Open-Lab-Starter-Kit/OLSK-Large-Laser/OLSK_Large_Laser_V1/README.md

<div align="center"><h1 style=align="center">OLSK Large Laser V1</h1></div>


<div align="center"><i>Open Source Laser Cutter - Large version - Open Lab Starter Kit</i></div>

<br>

Introduction
--

The OLSK Large Laser V1 is a powerful 75W CO2 laser cutter with large cutting area of 1000 x 700 mm. It can move at a high speed and precision of 0.05mm. With an innovative slim design (1520 x 1120 x 400 mm W x D x H), it is build with a full aluminum and an isolated cutting chamber, separated from the mechanics, electronics and laser optics. It includes a coaxial laser pointer and homing with inductive sensors. As an open source machine, it can be replicable in most Fab Labs and also industrially. The building have been simplified, compared to its predecessor Fabulaser Mini V2, with reduced number of parts and easier assembly process and laser calibration.

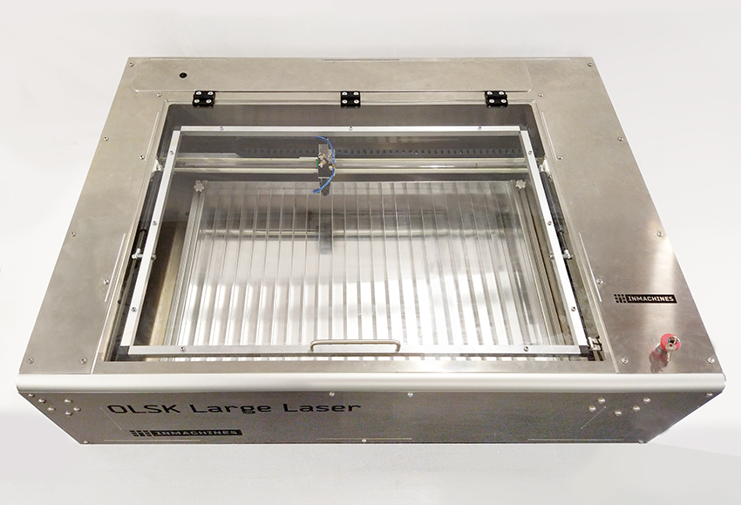
[picture p4: OLSK_Large_Laser_V1/media/OLSK_Large_Laser5_low-res.jpg]

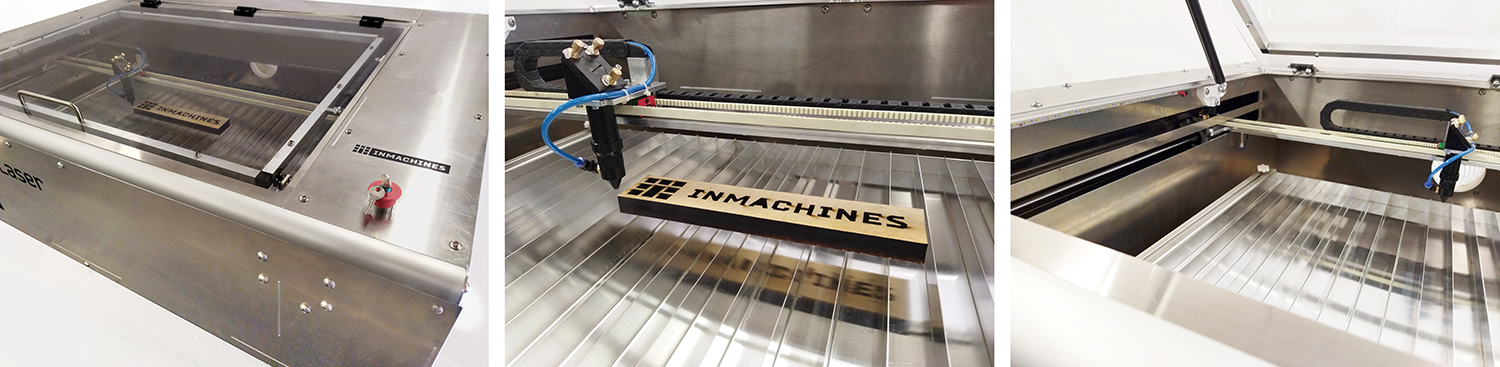
[picture p5: OLSK_Large_Laser_V1/media/Highlights.jpg]


Learning by Making
--

The assembly of the OLSK Large Laser provides a unique learning experience. With the help of a workshop with the InMachines team, this laser cutter can be built in a few days, allowing the participants to understand the role of each part and how the mechanics, optics and electronics function from inside out. We also provide a complete kit with all the required parts and machine accessories, so the user can save the time of production and procurement.

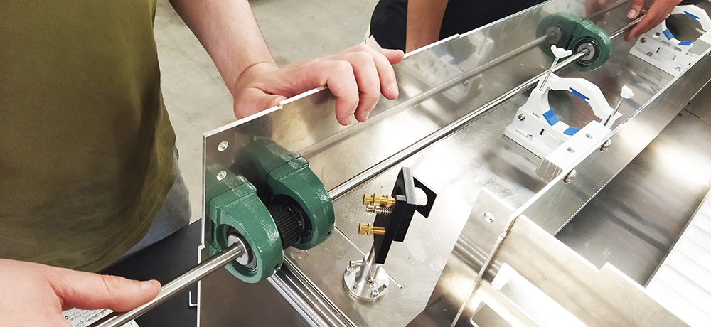
[picture p6: OLSK_Large_Laser_V1/media/Assembly1.jpg]


The Assembly Workbook
--

All OLSK machines are open source and have the BOM and necessary files available in this repository for replication. The assembly of parts is also documented in a workbook where each step contains a list of parts, tools and instruction remarks, following a logic order to provide a smooth assembly.

Specifications V1
--

- laser source: 75W CO2
- cooling system: water chiller
- cutting area: 1000 x 700 mm
- precision: 0.05 mm
- max. cutting thickness:
    - 25 mm wood
    - 10 mm acrylic
- frame and housing: 3 and 4mm CNC milled aluminum plates
- motion: HTD 5M belts
- max speed: 1000 mm/s
- bed: aluminum lamella
- guides: 15mm linear rail, 25mm linear shafts
- motors: stepper motors NEMA 24
- machine dimensions: 1520 x 1120 x 400 mm (WxDxH)
- firmware: GRBL-LPC firmware and MKS-SBASE
- custom PCB for signal handling
- with coaxial laser pointer
- completely enclosed housing
- homing with inductive sensors

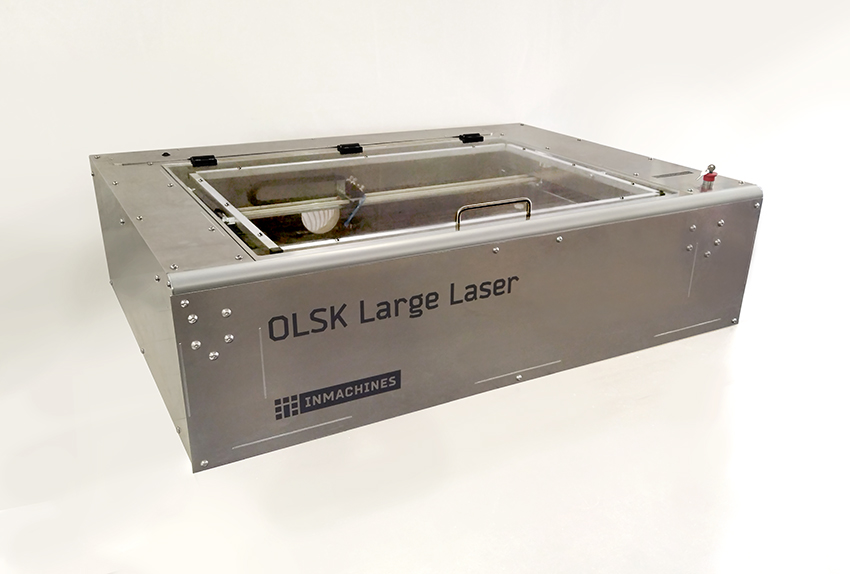
[picture p7: OLSK_Large_Laser_V1/media/OLSK Large Laser3_low-res.jpg]


Files
--

- **[CAD](cad)**
- **[PCB](PCB)**
- **[Firmware](grblHAL_Teensy4_OLSK_Large_Laser.zip)**
- **[BOM](Large_Laser_V1_BOM.pdf)**
- **[Assembly Workbook](OLSK_Large_Laser_V1_Workbook.pdf)**
- **[Wiring Schematic](OLSK_Large_Laser_V1_WiringSchematic_Board2022.pdf)**
- **[Settings](OLSK_Large_Laser.vcsettings)**

Author
--

OLSK Large Laser has been designed and built by **[InMachines Ingrassia GmbH](https://www.inmachines.net/)**.



<br>
Machine design:

- **[Daniele Ingrassia](https://www.linkedin.com/in/danieleingrassia/)**

The machine is part of the **[Open Lab Starter Kit (OLSK)](https://www.inmachines.net/open-lab-starter-kit)** group of open source digital fabrication machines.

OLSK is developed by **[InMachines Ingrassia GmbH](https://www.inmachines.net/)** for the **[Dtec project](https://dtecbw.de/home/forschung/hsu/projekt-fabcity)** at **[Fab City Hamburg](https://www.fabcity.hamburg/en/)**.

OLSK Partners:
<br><br>


Contact
--

- daniele@inmachines.net
- [https://www.inmachines.net/](https://www.inmachines.net/)

License
--

Hardware design, CAD and PCB files, BOM, settings and other technical or design files are released under the following license:

- CERN Open Hardware Licence Version 2 Weakly Reciprocal - **[CERN-OHL-W](LICENSE_CERN_OHL_W_V2.txt)**

Assembly manual, pictures, videos, presentations, description text and other type of media are released under the following license:

- Creative-Commons-Attribution-ShareAlike 4.0 International - **[CC BY-SA 4.0](LICENSE_CC_BY_SA_4.0.txt)**
