Open-Lab-Starter-Kit/OLSK-Large-Laser/OLSK_Large_Laser_V3_BOM.xlsx

Part Name | Amount
AC Jumper Cable | 1
ATC PCB | 1
Air Connector | 1
Air Panel | 2
Air Panel Spacer | 8
Back Beam Connector Left | 1
Back Beam Connector Right | 1
Back Cover | 1
Back Electronic Plate | 1
Back Inner Panel | 1
Back Inner Panel w/ glued parts | 1
Back Panel Bottom Connector | 1
Back Plate Bottom Connector | 2
Back Separator Panel | 2
Back Separator Panel w/ glued parts | 1
Beam Expander | 1
Beam Expander Holder | 1
Bed Adjuster | 4
Bed Back Beam | 1
Bed Front Beam | 1
Bed Horizontal Slat | 21
Bed Horizontal Support Slat | 2
Bed Side Beam | 2
Bed Support | 2
Bed Vertical Slat | 30
Belt Attacher | 6
Bottom Back Beam | 1
Bottom Front Beam | 1
Bottom Left Beam | 1
Bottom Middle Beam | 1
Bottom Panel | 1
Bottom Panel w/ glued parts | 1
Bottom Right Beam | 1
Bridge 2 | 6
CO2 Head Air Connector | 1
CO2 Head Air Pipe Support | 1
CO2 Head Air Tube | 1
CO2 Head Bottom | 1
CO2 Head Cover | 1
CO2 Head Mirror | 1
CO2 Head Plate | 1
CO2 Head Plate w/ glued parts | 1
CO2 Protective Plate | 1
Cable Duct 120 mm | 1
Cable Duct 1340 mm | 1
Cable Duct 155 mm | 3
Cable Duct 180 mm | 1
Cable Duct 225 mm | 3
Cable Duct 263 mm | 1
Cable Duct 350 mm | 1
Cable Duct 470 mm | 1
Cable Duct 600 mm | 1
Cable Duct 80 mm | 1
Cable Tie | 14
Camera | 2
Camera Cable | 2
Camera Frame | 2
Camera Mount Bottom | 2
Camera Mount Top | 2
Central Foot | 1
Central Side Foot | 2
Coaxial Red Pointer | 1
Conical Spacer Small | 23
Connector 2 Slots | 3
Controller PCB | 1
Controller PCB Power Cable | 1
Controller PCB USB Cable | 1
DC-DC Converter | 2
DIN Rail 150 mm | 1
DIN Rail 200 mm | 1
Diode Head Air Connector | 1
Diode Head Air Tube | 1
Diode Head PCB | 1
Diode Head Plate | 1
Diode Head Plate w/ glued parts | 1
Diode Laser Module | 1
Display | 1
Display Back Plate | 1
Display Cable Cover | 1
Display Cable Mount | 1
Display Frame | 1
Display Frame Spacer | 6
Display HDMI Cable | 1
Display Power Cable | 1
Display Touch Cable | 1
Dovetail Pin | 4
Driver Power Cable | 3
Earth Cable | 2
Emergency Button | 1
Ethernet Plug | 1
Exhaust Tube | 1
First Mirror Holder | 1
First Mirror Holder Support | 1
Front Beam Connector Left | 1
Front Beam Connector Right | 1
Front Panel | 1
Front Panel w/ glued parts | 1
Front USB Cable | 1
Grommet | 9
Head Air Connector | 1
Head Air Tube | 1
Head Cable | 1
Head Magnet | 6
Hinge | 3
Hinge Support | 3
Hook | 4
Joystick | 1
Joystick Back Support | 1
Joystick Jumper | 2
Joystick Support | 1
Jumper Power Cable | 1
Key Lock | 1
L Cable | 3
LED Light | 1
LED PCB Jumper Cable | 4
LED PCB Power Cable | 1
LED Strip | 2
Laser Adjuster | 2
Laser Adjuster Support | 2
Laser Filter Panel | 1
Laser Filter Panel Spacer | 1
Laser Power Cable | 1
Laser Source | 1
Laser Support | 1
Left Panel | 1
Left Panel w/ glued parts | 1
Linear Guide Cap | 119
Linear Motor Nut | 4
Middle Beam Connector Back | 1
Middle Beam Connector Front | 1
Motor Driver | 3
Mounting Plate Bearing | 2
Mounting Plate Bottom | 1
Mounting Plate Top | 1
N Cable | 3
Oldham Coupler - Bottom Part | 4
Oldham Coupler - Midde Part | 4
Oldham Coupler - Top Part | 4
PC | 1
PC Power Cable | 1
PC USB Cable | 1
Panel Connector 1 | 6
Panel Connector 2 | 13
Pin Holder | 1
Piston | 2
Piston Frame Connector Left | 1
Piston Frame Connector Right | 1
Piston Window Connector Left | 1
Piston Window Connector Right | 1
Plastic Screw M3-8 | 4
Power Supply 24V Small | 1
Power Supply 48V | 1
Power Supply Jumper Cable | 1
Power Switch | 1
RF Laser Jumper Cable | 1
RF Laser Logic Cable | 1
Relay | 1
Relay Module Jumper | 5
Right Panel | 1
Right Panel w/ glued parts | 1
Rubber Protection | 1
Rubber Washer | 2
Second Mirror Holder | 1
Separator Panel Left | 1
Separator Panel Left w/ glued parts | 1
Separator Panel Right | 1
Side Electronic Plate | 1
Side Handle | 4
Side Panel Magnet | 8
Spacer M8 | 4
Spring | 6
Standoff MF M3-10 | 4
Steel Beam | 6
Sub Window Rest Back | 1
Sub Window Rest Left | 1
Sub Window Rest Right | 1
Target | 2
Terminal | 26
Terminal Blue | 1
Terminal Cap | 5
Terminal Green | 1
Terminal Grey | 1
Threaded Ball | 4
Tool Holder | 1
Top Connector Back Left | 1
Top Connector Back Right | 1
Top Panel | 2
Top Panel w/ glued parts | 1
USB Connector | 1
USB Hub | 1
USB Hub Power Cable | 1
Washer M5 | 6
Window | 1
Window Back Beam | 1
Window Cable Chain | 1
Window Cable Chain Attachment | 1
Window Cable Chain Cover | 1
Window Cable Chain Frame Attacher | 1
Window Camera Beam | 2
Window Corner Connector Bottom | 4
Window Corner Connector Top | 4
Window Front Beam | 1
Window Handle | 1
Window Magnet | 1
Window Sensor | 1
Window Sensor Holder | 1
Window Side Beam | 2
Window Spacer Back | 1
Window Spacer Left | 1
Window Spacer Right | 1
Window T Connector Bottom | 2
Window T Connector Top | 2
Window w/ glued parts | 1
Wire Fixer | 15
X Beam | 1
X Belt | 1
X Belt Tensioner | 1
X Carriage | 1
X Chain | 1
X Chain End Support | 1
X Cover | 1
X Endstop | 1
X Endstop Cable Holder | 2
X Head Plate | 1
X Head Plate w/ glued parts | 1
X Left Pulley Holder | 1
X Linear Guide | 1
X Motor | 1
X Motor Belt | 1
X Motor Plate | 1
X Motor Pulley | 1
X Pulley 22T | 2
X Pulley 28T | 1
X Right Pulley Holder | 1
X Shaft Left | 1
X Shaft Right | 1
XY Driver Logic Cable | 2
Y Back Holder Left | 1
Y Back Holder Middle | 1
Y Back Holder Right | 1
Y Back Pulley Middle | 1
Y Back Pulley Sides | 2
Y Back Shaft | 1
Y Beam Left | 1
Y Beam Right | 1
Y Belt | 2
Y Belt Tensioner Left | 1
Y Belt Tensioner Right | 1
Y Carriage | 2
Y Chain | 1
Y Endstop | 1
Y Front Pulley | 2
Y Front Shaft | 2
Y Left Attacher | 1
Y Linear Guide | 2
Y Motor | 1
Y Motor Belt | 1
Y Motor Pulley | 1
Y Pulley Spacer | 3
Y Right Attacher | 1
Z Bottom Shaft Holder | 4
Z Endstop | 1
Z Endstop Spacer | 1
Z Linear Bearing | 4
Z Logic Cable | 1
Z Motor | 4
Z Motor Driver Cable | 1
Z Motor Jumper Cable | 8
Z Shaft | 4
Z Shaft Top Holder | 4
Fasteners
ISO 7380 M3-6 | 16
ISO 7380 M3-8 | 29
ISO 7380 M4-14 | 14
ISO 7380 M4-25 | 4
ISO 7380 M4-8 | 2
ISO 7380 M5-10 | 35
ISO 7380 M5-12 | 14
ISO 7380 M5-14 | 2
ISO 7380 M5-16 | 21
ISO 7380 M5-25 | 12
ISO 7380 M5-35 | 22
ISO 7380 M5-5 | 24
ISO 7380 M5-6 | 37
ISO 7380 M5-8 | 5
ISO 7380 M6-12 | 8
ISO 7380 M6-20 | 5
ISO 7380 M8-20 | 5
ISO 7380 M8-25 | 6
ISO 7380 M8-30 | 2
ISO 7380 M8-45 | 2
ISO 7380 M8-50 | 29
ISO 7380 M8-55 | 2
ISO 7380 M8-8 | 16
DIN 912 M10-30 | 2
DIN 912 M2.5-12 | 4
DIN 912 M2.5-16 | 2
DIN 912 M3-10 | 78
DIN 912 M3-12 | 2
DIN 912 M3-16 | 2
DIN 912 M3-6 | 59
DIN 912 M4-10 | 14
DIN 912 M4-12 | 6
DIN 912 M4-16 | 3
DIN 912 M4-45 | 7
DIN 912 M5-10 | 25
DIN 912 M5-12 | 8
DIN 912 M5-16 | 29
DIN 912 M5-20 | 14
DIN 912 M5-35 | 1
DIN 912 M5-70 | 2
DIN 912 M5-8 | 2
DIN 912 M8-16 | 5
DIN 912 M8-35 | 2
DIN 912 M8-45 | 4
DIN 912 M8-60 | 16
S-screw M5-40 | 6
DIN 985 M3 | 16
DIN 985 M4 | 13
DIN 985 M8 | 6
DIN 934 M3 | 2
DIN 934 M4 | 2
DIN 7991 M3-10 | 6
DIN 7991 M3-6 | 6
DIN 7991 M3-8 | 2
DIN 7991 M4-10 | 10
DIN 7991 M4-14 | 17
DIN 7991 M4-6 | 4
DIN 7991 M5-10 | 3
DIN 7991 M8-25 | 6
DIN 7991 M8-35 | 6
