Open-Lab-Starter-Kit/OLSK-Large-Laser/OLSK_Large_Laser_V1/BOM OLSK Large Laser V1.ods

BOM: OLSK Large Format Laser
Quantity | Part Name
 | Electronics
1 | MKS Sbase
1 | Power plug
1 | LRS-100-24
1 | TB6600 (1)
1 | Laser Power Supply YL-U1
1 | Laser Power Supply YL-U1 (1)
1 | Probe Converter PCB
2 | Cable Duct 25x40mm (1)
1 | Cable Chain 25x18 (1)
1 | Cable Chain 25x18
2 | CL57T Closed Loop Stepper Driver v1 v2
1 | PSU v48V 20A
 | X - Axis
1 | QHH15CA1T1200Z0C (1)
1 | Second Mirror Spacer
1 | Probe Nut (1) (1)
1 | Free Running HTD 5M 28T 9mm
1 | X Shaft 12mm
1 | Inductive Probe (1)
1 | X-endstop Holder
1 | 2nd Mirror Adjuster
1 | Probe Nut (1)
1 | X Motor 24HS40-5004D-E1000
1 | X Pulley Motor HTD 5M 28T 9mm
1 | Linear Bearing 25mm (1)
1 | 2nd Mirror Holder
1 | Cable Chain 15x15
1 | Linear Bearing 25mm
1 | Cable Chain 15x15 (1)
1 | X Plate (1)
1 | Cable Chain 25x18 (1) (1)
1 | Belt Fixer
1 | X-belt HTD 5M 10mm
3 | Belt Fixer (2)
1 | Chain Spacer
4 | 6801 (1)
 | Y - Axis
1 | YShaftLeft
1 | YShaftRight
1 | Shaft d12 100mm
1 | Y-endstop Holder
1 | Y-motor Holder
1 | UCPA201 (1) (1)
1 | UCPA201 (2)
1 | UCPA201
1 | UCPA201 (1)
1 | Y-belt
1 | Y-belt (1)
1 | Inductive Probe
1 | UCPA201 (3) (1) (2)
1 | HTD 5M 26Z 15mm (1) (1) (1) (1)
1 | HTD 5M 9mm 350
1 | Y-belt (2)
1 | UCPA201 (3) (1) (1) (2)
1 | Shaft d12 150mm
1 | 24HS40-5004D-E1000 (1)
1 | HTD 5M 26Z 15mm (1) (2) (1)
1 | UCPA201 (3) (2) (1)
1 | HTD 5M 16T 9mm
1 | HTD 5M 26T 9mm
1 | Shaft 1400mm
1 | UCPA201 (3) (1) (1) (2) (1)
1 | HTD 5M 26Z 15mm (1) (1) (1) (1) (2) (1)
1 | HTD 5M 26Z 15mm (1) (1) (1) (1) (1)
1 | UCPA201 (3) (1) (1) (1) (1)
 | Housing
3 | Hinge
1 | Front panel (1)
1 | Back panel (1)
1 | Left panel
1 | Right Panel
1 | Top Panel
1 | Bottom panel
1 | Inner plate right
1 | Inner panel left
1 | Laser separator
1 | Laser plane
1 | Cover Panel
1 | Window Spacer Left
1 | Window Spacer Right
1 | Window Spacer Back
1 | Sub Window Left
1 | Sub Window Right
1 | Sub Window Back
1 | Sub Window Front
 | Bed
1 | Bed Lamella (1)
1 | Alu Profil 4040 1900 (1) (1)
1 | Angle Profile
1 | Component237
1 | Bed Adjuster Test
 | Window
1 | Piston Support (1)
1 | Piston 400mm 150mm travel 100N
1 | Window Magnet (2) (1)
1 | Component242
1 | Component243
1 | Window Right Square Profile 20x20 680mm
1 | Window Left Square Profile 20x20 680mm
1 | Component246
1 | Window Magnet (1)
1 | Window Front Square Profile 20x20 996mm
1 | Window Back Square Profile 20x20 996mm
1 | Laser window (1)
1 | Window Handle 192
 | Frame
1 | Alu Profil 3030 (3) (6) (1) (1)
1 | Alu Profil 3030 vertical
1 | Alu Profil 3030 Fillet
 | Head
1 | Head Holder
1 | Component256
1 | Laser Head Bottom
1 | QHH15CA1T1200Z0C
1 | Laser Head Top (1)
1 | Yag Head Mirror Holder
1 | Belt Attacher
 | Laser
1 | Holder Rubber1
1 | CO2 Tube Holder Top (1)
1 | CO2 Tube Holder Bottom (1)
1 | Beam Head
1 | A1S 70W
1 | C02 First Mirror Holder (1)
1 | First Mirror Base
1 | Beam (1) (1)
1 | C02 First Mirror
1 | Beam (1)
1 | Beam
1 | Beam Middle 2
 | Fasteners
8 | DIN 912 M4 12mm
19 | ISO 7380 M8 10mm
2 | ISO 7380 M8 20mm
22 | ISO 7380 M8 12mm
3 | DIN 912 M5 10mm
6 | Lock Nut M5
8 | DIN 912 M4 8mm
2 | ISO 7045 M3 16mm
2 | ISO 4032 M3 nut
2 | ISO 7045 M3 6mm
6 | DIN 912 M4 25 mm
3 | ISO 7380 M5 16mm
5 | ISO 7380 M8 16mm
3 | DIN 912 M5 12 mm
11 | DIN 912 M6 30 mm
1 | ISO 14581 M3 4 mm
1 | DIN 912 M4 10mm
4 | DIN 912 M6 16mm
11 | DIN 985 M6 Nut
12 | DIN 7991 M8 35mm
2 | DIN 912 M4 10mm
1 | DIN 985 M8 Locknut
2 | DIN 912 M4 35 mm
12 | screw_iso_4762-m4x6-12_9
3 | screw_iso_4762-m4x10-10_9 (4)
10 | screw_iso_4762-m3x10-10_9
6 | Nylon Standoff Female-MaleM3 (1) (2)
6 | Plastic screw M3 8mm (1)
1 | ISO 7380 M5
1 | ISO 7380 M8 16mm (1)
4 | Lock Nut M4
4 | din6912_m4x45
4 | Washer M4
2 | Screw DIN_912 M4x8
4 | Locknut DIN_985 M8
12 | Screw ISO 7380-1 M10x12
4 | Screw ISO 7380-1 M8x16
7 | Screw ISO 7380-1 M8x20
10 | Screw ISO 7380-1 M10x12 (1)
3 | Screw ISO 7380-1 M8x20 (1)
1 | DIN985 M8 (2) (1) (1) (1) (1)
8 | screw_iso_7380-m8x10-12_9
4 | screw_iso_7380-m6x12-12_9
4 | T-nut 6 M6
8 | T-nut 6 M8
6 | screw_iso_7380-m8x25-12_9
2 | DIN 912 Cap Screw M4x10
2 | Lock Nut M3
8 | din6912_m5x16
2 | din_en_iso_4762_m3x12
4 | T-nut M8
4 | DIN 125 M8 Washer (235) (1) (1) (2) (1) (1) (1)
4 | DIN 933 M8 150mm (1) (1)
4 | DIN985 M8 (2) (1) (2)
