Open-Lab-Starter-Kit/OLSK-Large-Laser/(threads)

Thread 1 (2024-04-23):

Add Dip-Switch Position to Electrical Wiring Schematic

mikelovic, 2024-04-23:
https://github.com/Open-Lab-Starter-Kit/OLSK-Large-Laser/blob/main/OLSK_Large_Laser_V1_WiringSchematic_Board2022.pdf

would be helpful to add the information of dip-switches position of the 2 motor drivers X, Y.

licash, 2024-04-25:
The dip switches position was added to the wiring schematic.

Closed 2024-04-25.
