Open-Lab-Starter-Kit/OLSK-Large-Laser/OLSK_Large_Laser_V3_WiringSchematic.pdf

X-AXIS FRONT PANEL | RIGHT SIDE

# OLSK LARGE LASER V2

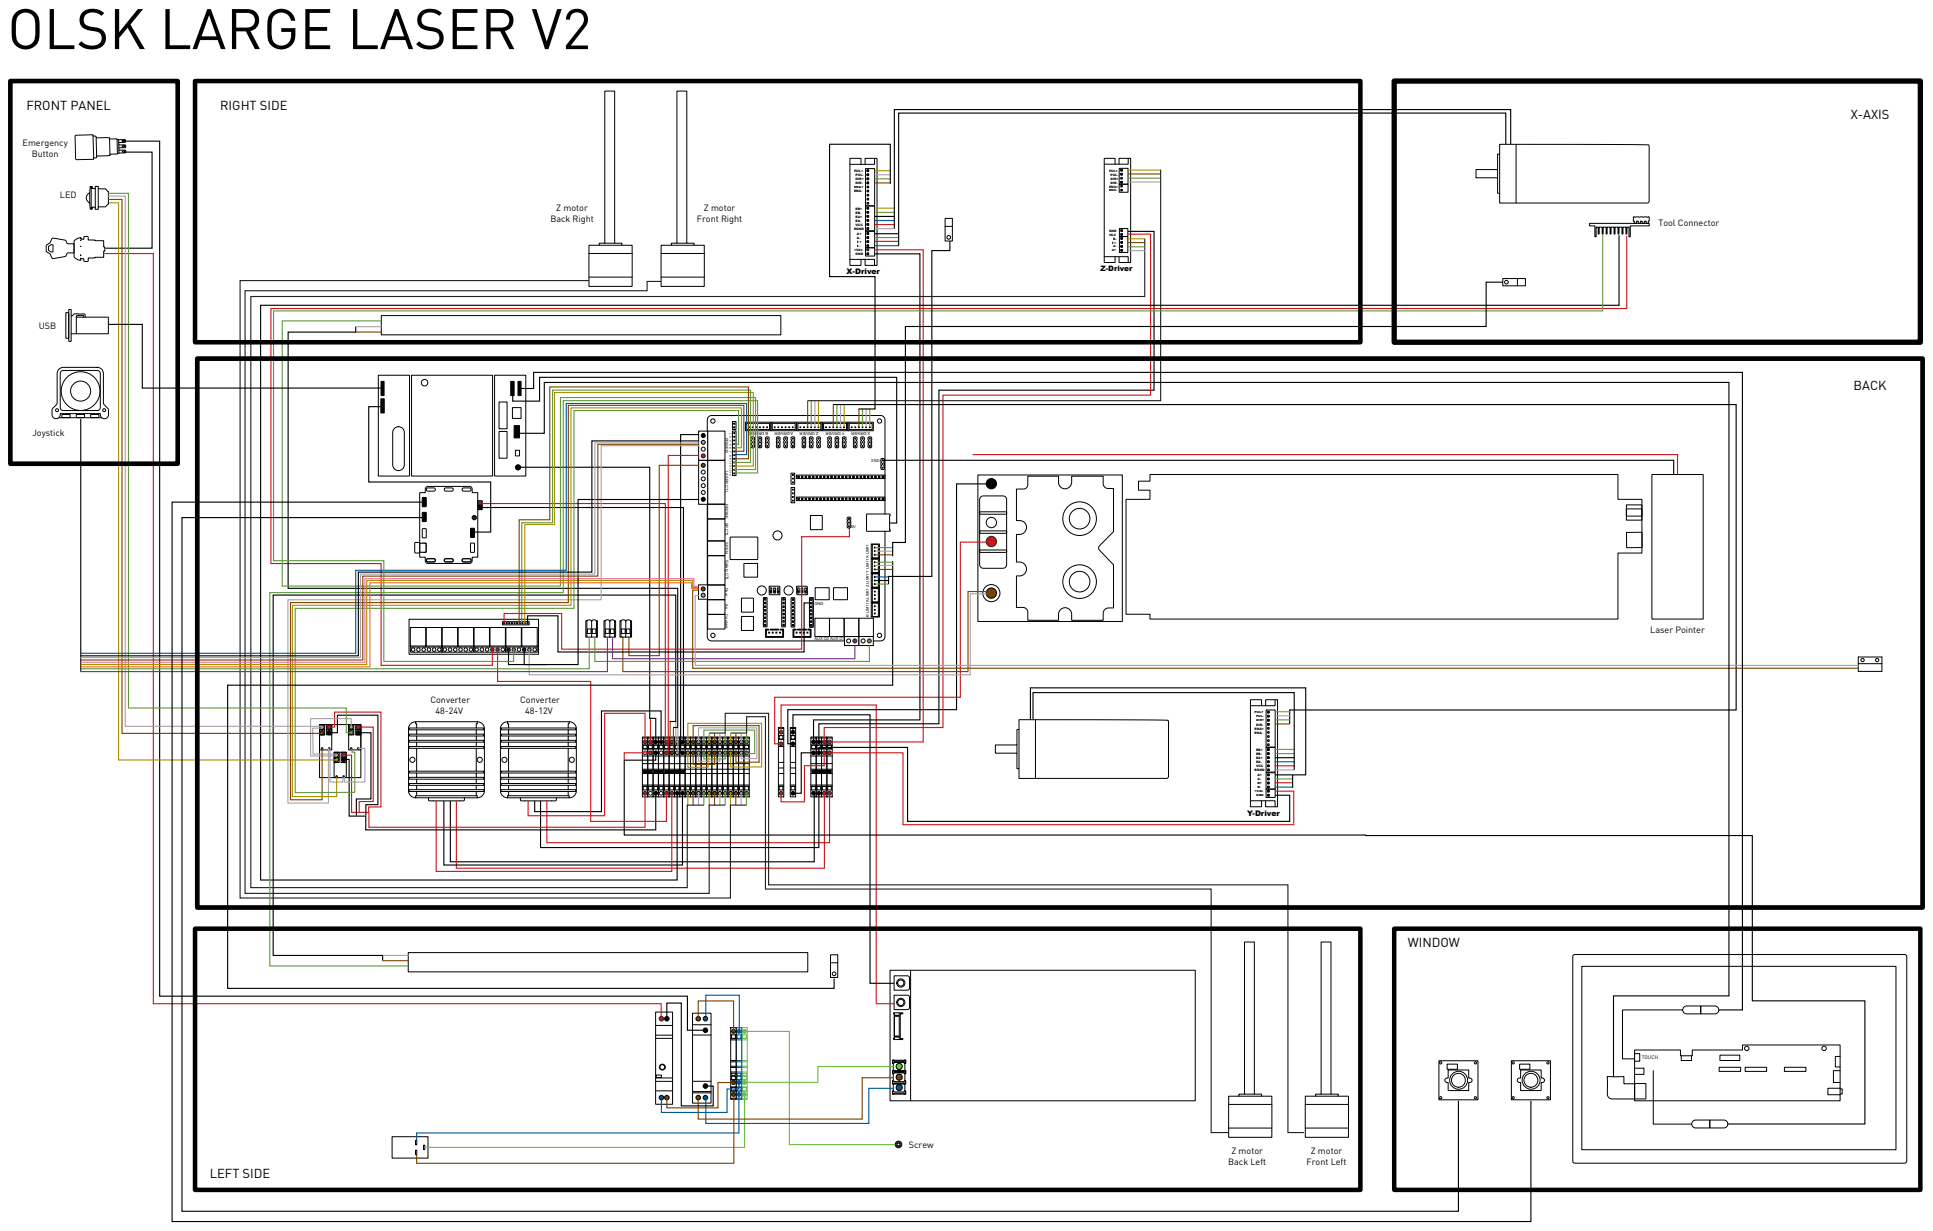
[picture p8: page 1]
GND; DIR+; PUL+; VCC; +Vdc; DIR- ENA+; EGND; Y-Driver; ENA-; PUL-; X-Driver; ENA+ ENA-; DIR-; Z-Driver; AUX O2 AUX O1; Door PROBE; A LIMIT; Converter 48-24V; Converter 48-12V; Z motor Back Left; Z motor Back Right; Z motor Front Right; Z motor Front Left; WINDOW; LEFT SIDE; BACK; Screw; Tool Connector; Laser Pointer; TOUCH; USB; Joystick; LED; Emergency Button

POWER 13 12 11 10 9 8 7 6 5 4 3 2 LASER CTL SP CTL SP EN Safety CTL Air Coolant B LIMIT Z LIMIT Y LIMITX LIMIT
