Open-Lab-Starter-Kit/OLSK-Large-Laser/OLSK_Large_Laser_V1/OLSK_Large_Laser_V1_Wiring Schematic_Board2022.pdf

# Y-endstop

# X-endstop

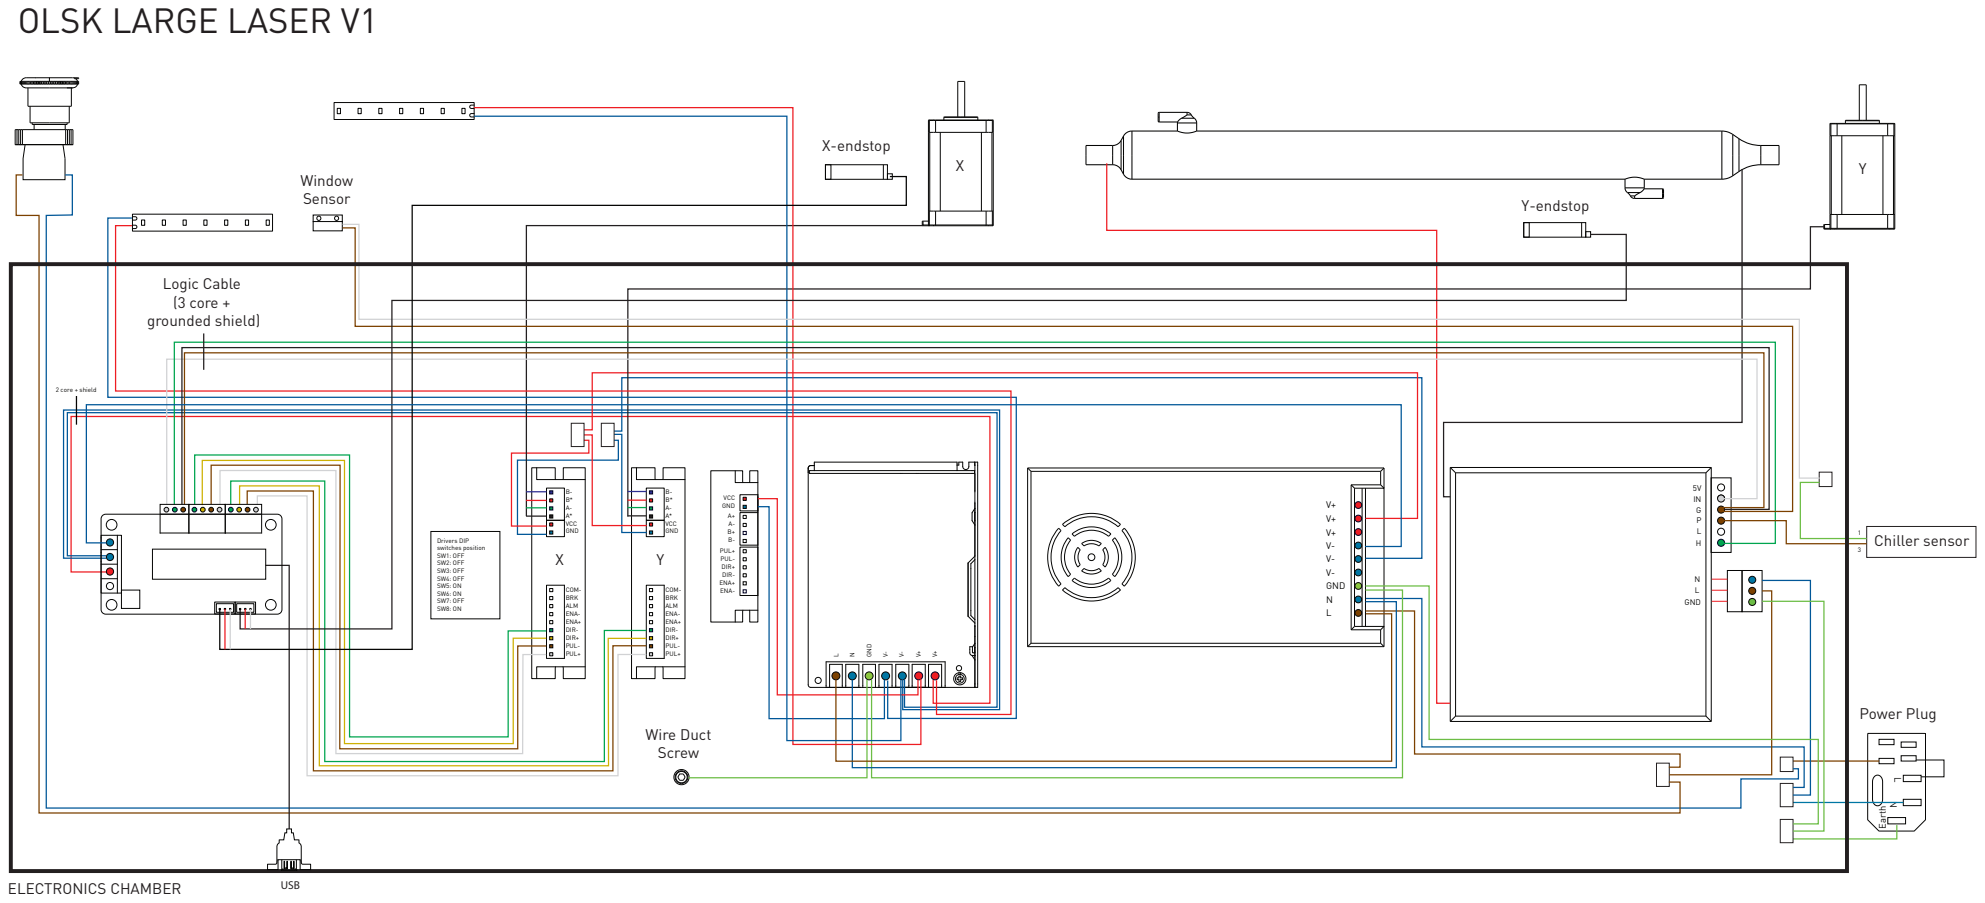
[picture p9: page 1]
V- GND N L; GND; VCC; ENA-; PUL+; PUL-; ENA+; DIR+; DIR-; COM- BRK ALM; Earth L; VCC GND; Chiller sensor; Window Sensor; Wire Duct Screw; Power Plug; Logic Cable (3 core + grounded shield); USB; ELECTRONICS CHAMBER; 2 core + shield; Drivers DIP switches position SW1: OFF SW2: OFF SW3: OFF SW4: OFF SW5: ON SW6: ON SW7: OFF SW8: ON

OLSK LARGE LASER V1
