Open-Lab-Starter-Kit/OLSK-Large-Laser/OLSK_Large_Laser_V1/PCB/Schematic_Teensy Laser w_o Eth_V3_CORRECTED VALUES__2023-01-18 (1).pdf

## Y_Step

## GND

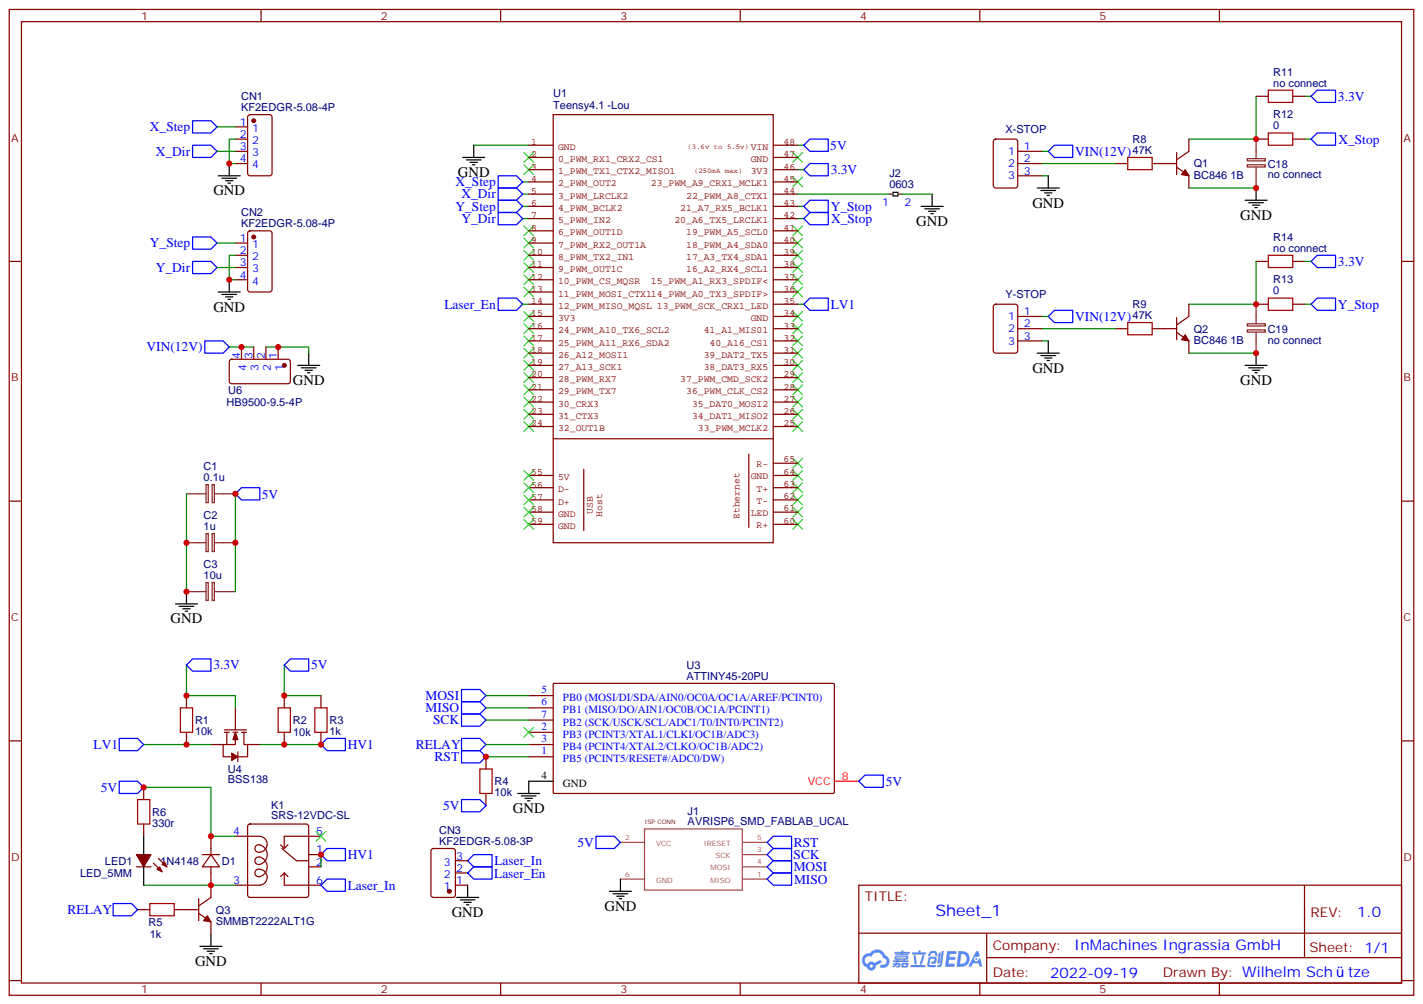
[picture p10: page 1]

Company: InMachines Ingrassia GmbH

Drawn By: Wilhelm Sch tze
