Open-Lab-Starter-Kit/OLSK-Large-Laser/OLSK_Large_Laser_V1/OLSK_Large_Laser_V1_Workbook.pdf

Step
Number | Step Title | | Parts list | | Tools list
Remarks
| | Quantity | Part name | Quantity | Tool name
01 | Bottom Panel | 1 | Bottom Panel | 1 | Allen Key 5.0

Do not tighten the screws yet for further alignment.

| | 8 | B-screw M8-10
| | | | 1 | Allen Key 4.0

On the right profile, insert T-nuts M6 and attach it to the Bottom Panel, with the cable duct on top.

| | 4 | B-screw M6-12 | 1 | Ruler

Position the cable duct starting about 70 mm from the front of the machine.

| | 3 | Profile 30-1100
| | 1 | Cable Duct
| | 8 | T-nut M8
| | 4 | T-nut M6
02 | Attach Electronics | 2 | Motor Driver | 1 | Allen Key 2.5
All motor drivers should have the switches pointing outwards.
| | 1 | Small Motor Driver
| | | | 1 | Allen Key 3.0
| | 1 | Logic Power Supply
| | 1 | Laser Power Supply
| | 1 | Controller PCB
| | 4 | Plastic Screw M3-8
| | 4 | Standoff M3 MF
| | 6 | C-screw M3-10
| | 3 | C-screw M3-6
| | 4 | C-screw M4-6

### 03.1 Inner Right Panel

| | 1 | Inner Right Panel | 1 | Allen Key 3.0

Attach the parts before inserting the panel in the Bottom Panel.
| | 1 | Motor Power Supply
| | 3 | C-screw M4-6

### 03.2 Y-motor

| | 1 | Cable Duct
| | | | 1 | Allen Key 3.0

Fix the pulley on the motor shaft aligning it to the edge, with the setscrews towards the motor side.

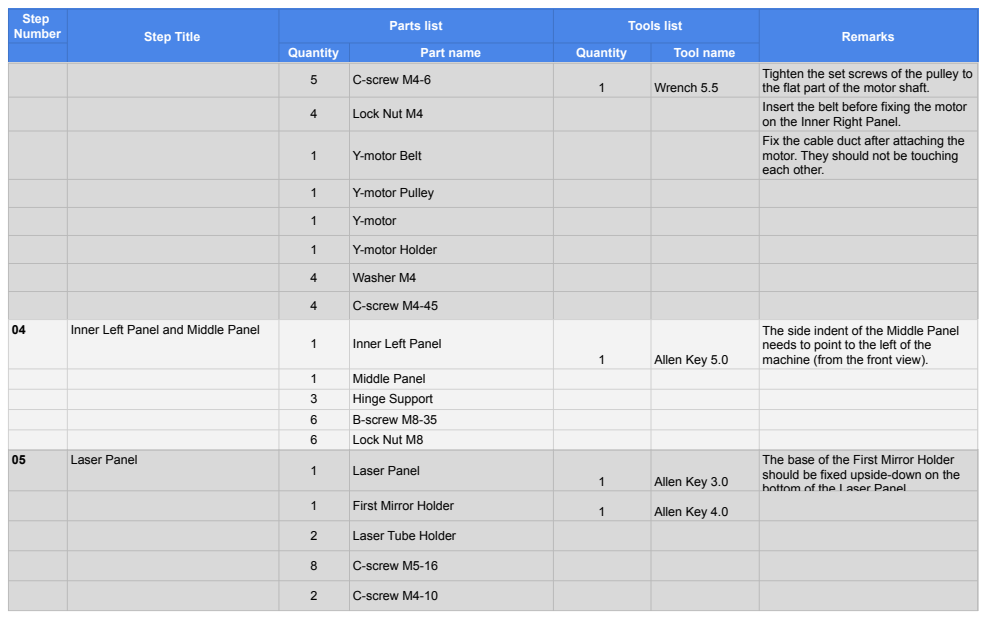
[picture p11: page 2]
C-screw M4-6; Wrench 5.5; Lock Nut M4; Insert the belt before fixing the motor; Y-motor Belt; Y-motor Pulley; Y-motor; Y-motor Holder; Washer M4; C-screw M4-45; Inner Left Panel; Allen Key 5.0; Middle Panel; Hinge Support; B-screw M8-35; Lock Nut M8; 05 Laser Panel; Laser Panel; Allen Key 3.0; First Mirror Holder; Allen Key 4.0; Laser Tube Holder; C-screw M5-16; C-screw M4-10

Step Number | Step Title | Parts list | Tools list | Remarks

Quantity | Part name | Quantity | Tool name

Tighten the set screws of the pulley to
the flat part of the motor shaft.

on the Inner Right Panel.
Fix the cable duct after attaching the
motor. They should not be touching
each other.

04 Inner Left Panel and Middle Panel

The side indent of the Middle Panel
needs to point to the left of the
machine (from the front view).

The base of the First Mirror Holder
should be fixed upside-down on the
bottom of the Laser Panel.

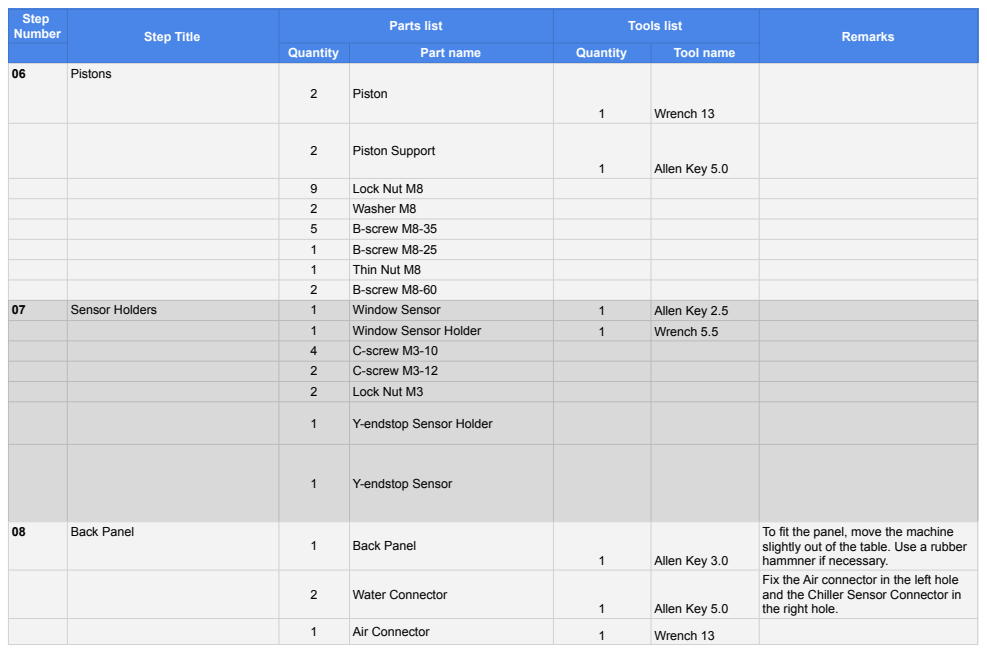
[picture p12: page 3]
06 Pistons; Piston; Wrench 13; Piston Support; Allen Key 5.0; Lock Nut M8; Washer M8; B-screw M8-35; B-screw M8-25; Thin Nut M8; B-screw M8-60; Sensor Holders; Window Sensor; Allen Key 2.5; Window Sensor Holder; Wrench 5.5; C-screw M3-10; C-screw M3-12; Lock Nut M3; Y-endstop Sensor Holder; Y-endstop Sensor; 08 Back Panel; Back Panel; Allen Key 3.0; Water Connector; Air Connector

Step Number | Step Title | Parts list | Tools list | Remarks

Quantity | Part name | Quantity | Tool name

To fit the panel, move the machine
slightly out of the table. Use a rubber
hammner if necessary.
Fix the Air connector in the left hole
and the Chiller Sensor Connector in
the right hole.

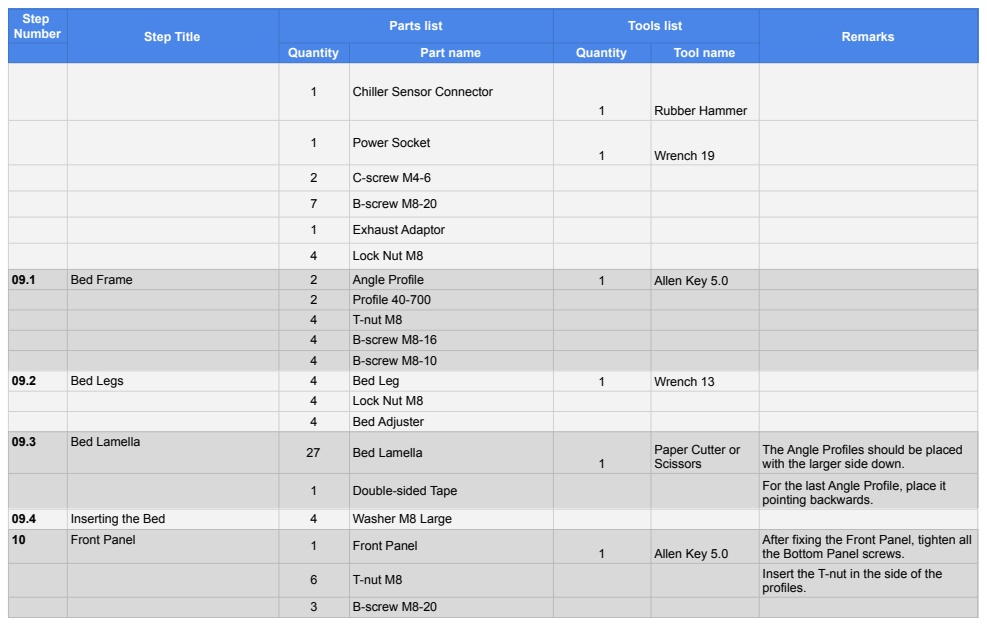
[picture p13: page 4]
Chiller Sensor Connector; Rubber Hammer; Power Socket; Wrench 19; C-screw M4-6; B-screw M8-20; Exhaust Adaptor; Lock Nut M8; Bed Frame; Angle Profile; Allen Key 5.0; Profile 40-700; T-nut M8; B-screw M8-16; B-screw M8-10; Bed Legs; Bed Leg; Wrench 13; Bed Adjuster; 09.3 Bed Lamella; Bed Lamella; Double-sided Tape; For the last Angle Profile, place it; pointing backwards.; Inserting the Bed; Washer M8 Large; Front Panel; Insert the T-nut in the side of the; profiles.

Step Number | Step Title | Parts list | Tools list | Remarks

Quantity | Part name | Quantity | Tool name

Paper Cutter or
Scissors

The Angle Profiles should be placed
with the larger side down.

After fixing the Front Panel, tighten all
the Bottom Panel screws.

Step Number | Step Title | Parts list | Tools list | Remarks
Quantity | Part name | Quantity | Tool name
11 | Y-axis Guide | 2 | Y-linear Shaft | 1 | Allen Key 6.0
Insert the Y-guide Blocks in the guide before fixing it.
| | 1 | Y-bearing Block Left
1 | Wrench 10 | Work with 2 people.
1 | Y-bearing Block Right | Insert the Hex Screw in the Y-bearing
Block Right.
| | 4 | B-screw M12-20
| | 1 | Hex Screw M6-12

### 12.1 Y-axis Motion Back 1

| | 5 | Bearing Unit
| | | | 1 | Allen Key 6.0

The Bearing units need to be fixed with the setscrews pointing left (right side of the machine looking from the front).
| | 10 | B-screw M10-12

### 12.2 Y-axis Motion Back 2

| | 1 | Y-shaft 1400
| | | | 1 | Lubricant

For inserting the shaft, the bearings of the Bearing Units can tilt. Use some force and lubricant.

| | 2 | Y-pulley 26-5M-15
| | | | 1 | Rubber Hammer

Pulleys need to be inserted while inserting the shaft, with setscrews pointing left (right side of the machine looking from the front).
4 | Setscrew | Y Pulley 26-5M-15
1 | Y-pulley 26-5M-09 | Start inserting the shaft from the left
side of the machine.
12.3 | Y-axis Motion Front | 4 | Bearing Unit | 1 | Allen Key 6.0
| | 2 | Y Pulley 26-5M-15
| | 2 | Setscrew
| | 1 | Y-shaft Left 100
| | 1 | Y-shaft Right 150
| | 8 | B-screw M10-12

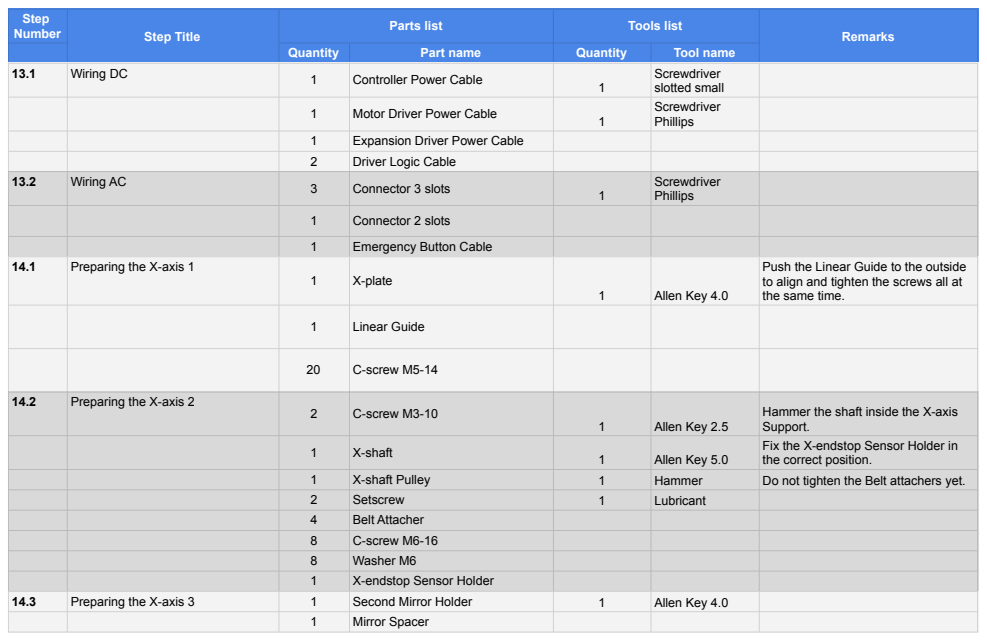
[picture p14: page 6]
Wiring DC; Controller Power Cable; Screwdriver slotted small; Motor Driver Power Cable; Screwdriver Phillips; Expansion Driver Power Cable; Driver Logic Cable; Wiring AC; Connector 3 slots; Connector 2 slots; Emergency Button Cable; X-plate; Allen Key 4.0; Linear Guide; C-screw M5-14; C-screw M3-10; Allen Key 2.5; X-shaft; Allen Key 5.0; X-shaft Pulley; Hammer; Do not tighten the Belt attachers yet.; Setscrew; Lubricant; Belt Attacher; C-screw M6-16; Washer M6; X-endstop Sensor Holder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

Step Number | Step Title | Parts list | Tools list | Remarks

Quantity | Part name | Quantity | Tool name

14.1 Preparing the X-axis 1

Push the Linear Guide to the outside
to align and tighten the screws all at
the same time.

14.2 Preparing the X-axis 2

Hammer the shaft inside the X-axis
Support.
Fix the X-endstop Sensor Holder in
the correct position.

Step Number | Step Title | Parts list | Tools list | Remarks
Quantity | Part name | Quantity | Tool name
| | 2 | C-screw M4-25
15 | Attaching the X-axis | 1 | Linear Guide Carriage | 1 | Allen Key 5.0

Insert the Linear Guide carefully, removing the plastic linear guide.

| | 8 | B-screw M8-20

Insert the carriage after passing the X-axis through the bottom slot of the Inner left Panel.
1 | X-endstop Sensor | Tighten the cable of the X-endstop
sensor on the body of the sensor
| | 1 | Cable Tie
16 | Attaching the X-motor | 1 | X-motor | 1 | Allen Key 3.0
| | 4 | B-screw M5-20 | 1 | Wrench 8
| | 4 | Lock Nut M5
| | 1 | X-motor Pulley
| | 2 | Setscrew

### 17 Install LEDs

| | 2 | LED Strip
| | | | 1 | Allen Key 3.0

The cables of the LED strip should point to the holes in the Inner side panels.
| | 2 | C-wire Fixer
| | 4 | C-screw M4-10
| | 2 | U-wire Fixer
18 | Top Profiles | 2 | Profile 3060-1100 | 1 | Allen Key 6.0
| | 6 | B-screw M10-20
6 | T-nut M8 | Insert the T-nuts in the profiles

### 19 Y-belts

2 | Y-belt 230 cm
1 | Large Pliers

To tighten the Y-belts, loosen the front Bearing Units. Then fix one end of the belt with the Belt attacher gripping the belt teeth. Pass the belt around the pulley and fix the other end of the belt. Then tighten the Bearing units again to tension the belts.

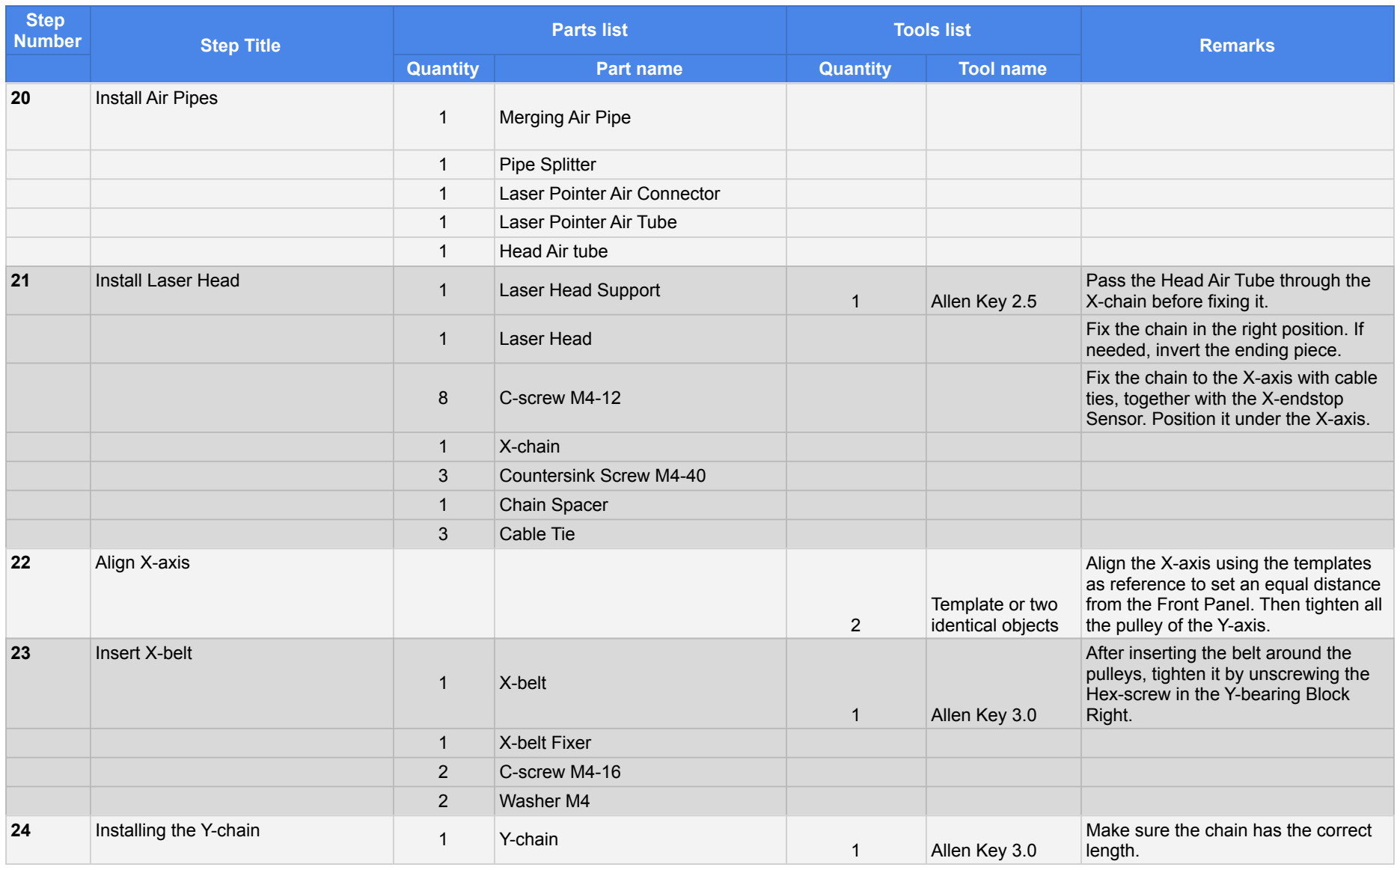
[picture p15: figure]
Quantity; Part name; Tool name; 20 Install Air Pipes; Merging Air Pipe; Pipe Splitter; Laser Pointer Air Connector; Laser Pointer Air Tube; Head Air tube; Install Laser Head; Laser Head Support; Allen Key 2.5; Pass the Head Air Tube through the X-chain before fixing it.; needed, invert the ending piece.; C-screw M4-12; Fix the chain to the X-axis with cable ties, together with the X-endstop Sensor. Position it under the X-axis.; X-chain; Countersink Screw M4-40; Chain Spacer; Cable Tie; 22 Align X-axis; Template or two identical objects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

Step Number | Step Title | Parts list | Tools list | Remarks
1 | Laser Head | Fix the chain in the right position. If

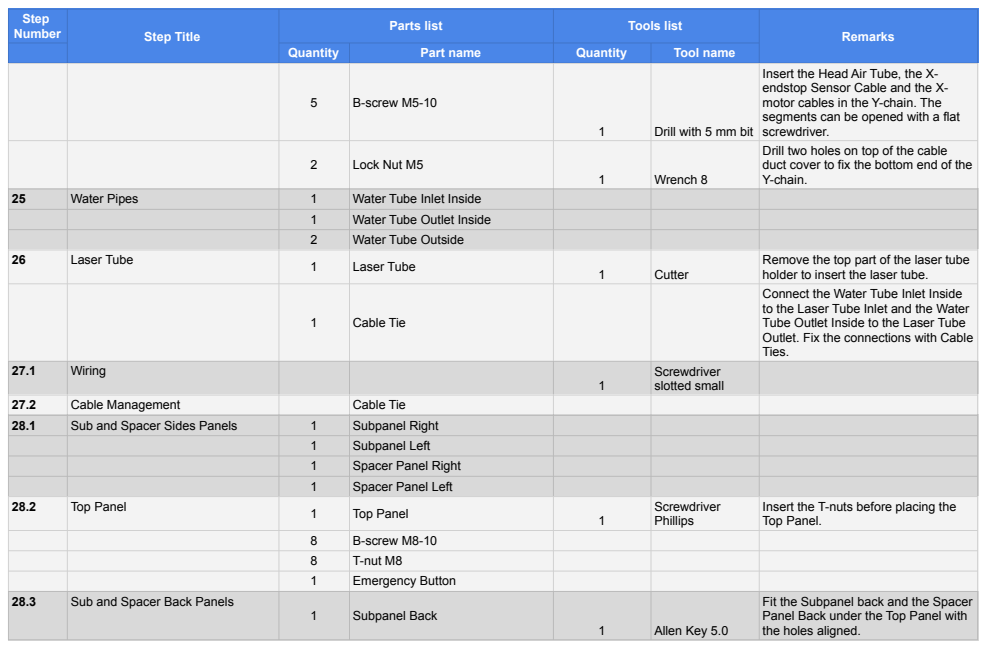
[picture p16: page 9]
B-screw M5-10; Drill with 5 mm bit; Lock Nut M5; Wrench 8; Water Pipes; Water Tube Inlet Inside; Water Tube Outlet Inside; Water Tube Outside; Laser Tube; Cutter; Cable Tie; 27.1 Wiring; Screwdriver slotted small; Cable Management; Sub and Spacer Sides Panels; Subpanel Right; Subpanel Left; Spacer Panel Right; Spacer Panel Left; Top Panel; Screwdriver Phillips; B-screw M8-10; T-nut M8; Emergency Button; Subpanel Back; Allen Key 5.0

Step Number | Step Title | Parts list | Tools list | Remarks

Quantity | Part name | Quantity | Tool name

Insert the Head Air Tube, the X-
endstop Sensor Cable and the X-
motor cables in the Y-chain. The
segments can be opened with a flat
screwdriver.
Drill two holes on top of the cable
duct cover to fix the bottom end of the
Y-chain.

Remove the top part of the laser tube
holder to insert the laser tube.
Connect the Water Tube Inlet Inside
to the Laser Tube Inlet and the Water
Tube Outlet Inside to the Laser Tube
Outlet. Fix the connections with Cable
Ties.

Insert the T-nuts before placing the
Top Panel.

28.3 Sub and Spacer Back Panels

Fit the Subpanel back and the Spacer
Panel Back under the Top Panel with
the holes aligned.

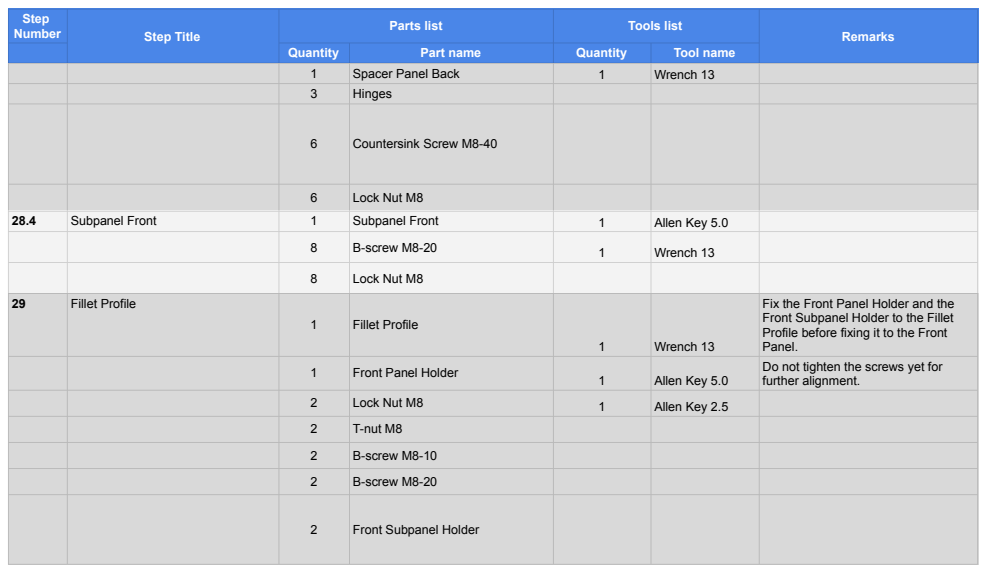
[picture p17: page 10]
Spacer Panel Back; Wrench 13; Hinges; Countersink Screw M8-40; Lock Nut M8; Subpanel Front; Allen Key 5.0; B-screw M8-20; 29 Fillet Profile; Fillet Profile; Front Panel Holder; Allen Key 2.5; T-nut M8; B-screw M8-10; Front Subpanel Holder

Step Number | Step Title | Parts list | Tools list | Remarks

Quantity | Part name | Quantity | Tool name

Fix the Front Panel Holder and the
Front Subpanel Holder to the Fillet
Profile before fixing it to the Front
Panel.
Do not tighten the screws yet for
further alignment.

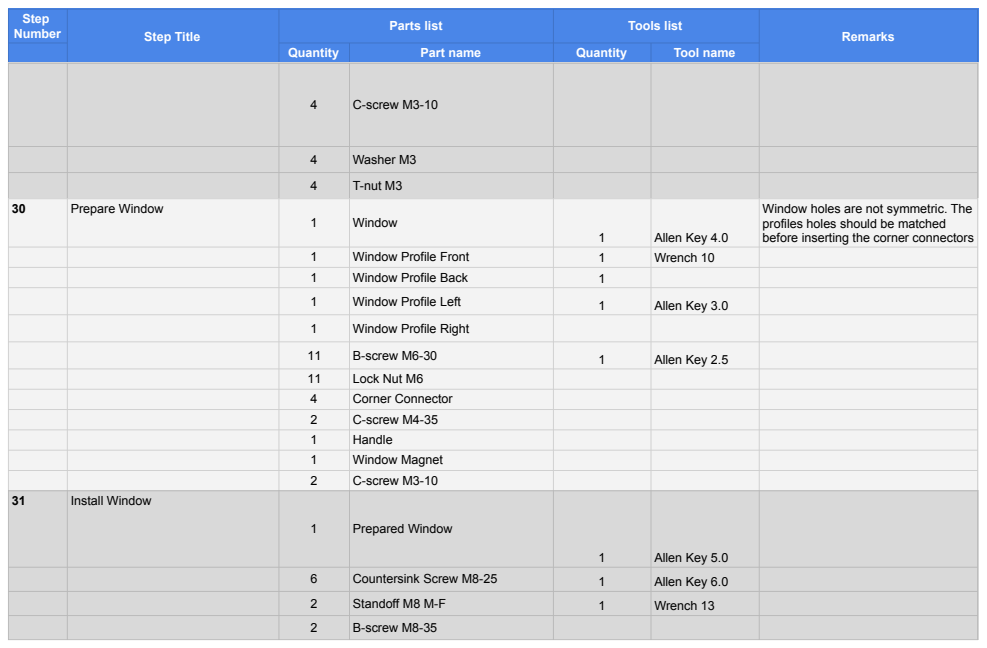
[picture p18: page 11]
C-screw M3-10; Washer M3; T-nut M3; 30 Prepare Window; Window; Allen Key 4.0; Window Profile Front; Wrench 10; Window Profile Back; Window Profile Left; Allen Key 3.0; Window Profile Right; B-screw M6-30; Allen Key 2.5; Lock Nut M6; Corner Connector; C-screw M4-35; Handle; Window Magnet; 31 Install Window; Prepared Window; Allen Key 5.0; Countersink Screw M8-25; Allen Key 6.0; Standoff M8 M-F; Wrench 13; B-screw M8-35

Step Number | Step Title | Parts list | Tools list | Remarks

Quantity | Part name | Quantity | Tool name

Window holes are not symmetric. The
profiles holes should be matched
before inserting the corner connectors

Step Number | Step Title | Parts list | Tools list | Remarks
Quantity | Part name | Quantity | Tool name
| | 6 | Washer M8
| | 2 | Lock Nut M8
32 | Prepare for Calibration | 1 | Air Compressor | 1 Digital Level meter Semi-tighten the screws of the laser tube holder and first mirror.
| | 1 | Chiller | Test the water.
| | 1 | Water Flow Sensor Cable | Make sure the tube is parallel to the frame and horizontally levelled.
| | 1 | Air Tube Outside | Pre-align visually first mirror, second mirror and laser tube.
| | 1 | Air Compressor Adapter
33 | Insert Mirrors | 3 | Mirror | Do not touch the surface of the mirrors.
34 | Insert Lens | 1 | Lens | Place it with the flat surface down.
| | 2 | Rubber Ring | Do not touch the surface of the lens.

### 35 Fix Top Back Panel

| | 1 | Laser Pointer Switch
1 | Allen Key 2.5
| | 1 | Laser Pointer Cable
| | 1 | Top Back Panel
| | 8 | B-screw M4-10

### 36 Insert Side Panels

| | 1 | Left Panel
1 | Allen Key 5.0
| | | | Tighten the screws of the Front Panel Holder and the Front Subpanel Holder.
| | 1 | Right Panel | To fix the Side Panels, insert them in the slot of the Front Panel first.

Step Number | Step Title | Parts list | Tools list | Remarks
Quantity | Part name | Quantity | Tool name
| | 12 | B-screw M8-10
| | 2 | B-screw M8-20
| | 1 | USB Cable Inside
| | 2 | Plastic Screw M3-8
