Open-Lab-Starter-Kit/OLSK-Large-Laser/(list of files, drawings)

Other design files:
OLSK_Large_Laser_V1/PCB/PCB_PCB_Teensy Laser w o Eth_V2 copy copy_2023-01-18.json
OLSK_Large_Laser_V1/PCB/SCH_Teensy Laser w o Eth_V3 CORRECTED VALUES_2023-01-18.json
