Open-Lab-Starter-Kit/OLSK-Large-Laser/(commit log)

2023-01-10 added intro, specifications, imaages and cad
2023-01-11 Upload wiring schematic and workbook
2023-01-11 Update README.md
    Added Learning by making and assembly
2023-01-18 upload board
    [PCB_PCB_Teensy Laser w o Eth_V2 copy copy_2023-01-18.json, SCH_Teensy Laser w o Eth_V3 CORRECTED VALUES_2023-01-18.json]
2023-02-15 Update README.md
    Added BOM and PCB
2023-02-15 upload bom
2023-02-15 Update README.md
    updated bom
2023-04-17 added BOM files and updated 3D design
    [BOM OLSK Large Laser V1.ods, BOM OLSK Large Laser V1.xlsx]
2025-03-11 Upload Assembly Manual
2025-03-12 Move V1 to folder
    [BOM OLSK Large Laser V1.ods, BOM OLSK Large Laser V1.xlsx, PCB_PCB_Teensy Laser w o Eth_V2 copy copy_2023-01-18.json, SCH_Teensy Laser w o Eth_V3 CORRECTED VALUES_2023-01-18.json]
2025-03-14 Update Assembly Manual
2025-05-05 Add REUSE licensing metadata
    - Add REUSE-compliant dep5 copyright file
    - Add AGPL-3.0, GPL-3.0, CC-BY-SA-4.0, CC0-1.0, CERN-OHL-W-2.0, and custom font license texts
    - Rename BOM file to REUSE-compliant name
    [OLSK_Large_Laser_V3_BOM.xlsx]
